Dong-quan/STM32_LoRa_IoT_Output_Controller/README.md

# STM32 LoRa IoT Output Controller



[]()
[]()
[]()

---

## Table of Contents

1. [Overview](#overview)
2. [Design Requirements](#design-requirements)
3. [Hardware Design](#hardware-design)
   - [System Architecture](#system-architecture)
   - [Schematic](#schematic)
   - [PCB Layout and Routing](#pcb-layout-and-routing)
4. [Repository Structure](#repository-structure)
5. [Getting Started](#getting-started)
6. [Author](#author)

---

## Overview

This project is an **IoT output controller board** designed in KiCad. An **STM32F103C8T6** reads isolated digital inputs, drives power outputs and talks to a remote node through a **LoRa** module. It is built to run field equipment such as a pump, two valves, a fan, a light, a buzzer and a curtain motor, so it fits a greenhouse or smart-agriculture system.

Field circuits are separated from the logic side with **optocouplers**, which protects the MCU from noise and faults on the load side. The board can be powered from mains (AC-DC module) and from a 12 / 24 V DC source.

Main functions:

- **Control** the pump, valve 1, valve 2, fan and light with opto-isolated MOSFET outputs.
- **Switch** two relay outputs for larger AC loads.
- **Drive a motor** (for example a curtain) through a **BTS7960** H-bridge interface with PWM and high-speed optocouplers.
- **Read** six isolated inputs: four switches and two limit switches.
- **Communicate** over LoRa (UART, with M0, M1 and AUX control) and over a USART port.
- **Indicate** status with LEDs and a buzzer.

---

## Design Requirements

### Summary

| Item | Target |
| --- | --- |
| MCU | STM32F103C8T6 (8 MHz crystal, 32.768 kHz RTC crystal) |
| Wireless | LoRa module over UART |
| Power input | AC mains (AC-DC module) or 12 / 24 V DC |
| Logic supply | 5 V and 3.3 V, separated from the load supply |
| Inputs | 6 opto-isolated digital inputs |
| Outputs | 5 MOSFET outputs, 2 relays, 1 H-bridge interface |
| Programming | SWD |
| Revision | V1.0 |

### Functional requirements

**Power**
- Fuse, varistor and EMI filter on the AC input
- AC-DC module for 5 V, and a buck converter for 12 / 24 V DC input
- 3.3 V LDO for the MCU, LoRa and input side
- Reverse-polarity protection and a TVS or Zener clamp on the DC input

**Inputs**
- Six opto-isolated inputs (4 switches and 2 limit switches), with resistor values for 12 V and 24 V operation
- Status LED on each channel

**Outputs**
- Five MOSFET outputs with flyback protection, isolated by optocouplers
- Two relay outputs
- BTS7960 H-bridge interface with LPWM and RPWM through high-speed optocouplers

**Microcontroller and communication**
- STM32 MCU with SWD, USART, reset button and boot pin
- LoRa module interface (TX, RX, M0, M1, AUX)
- Buzzer and test LED

---

## Hardware Design

### System Architecture

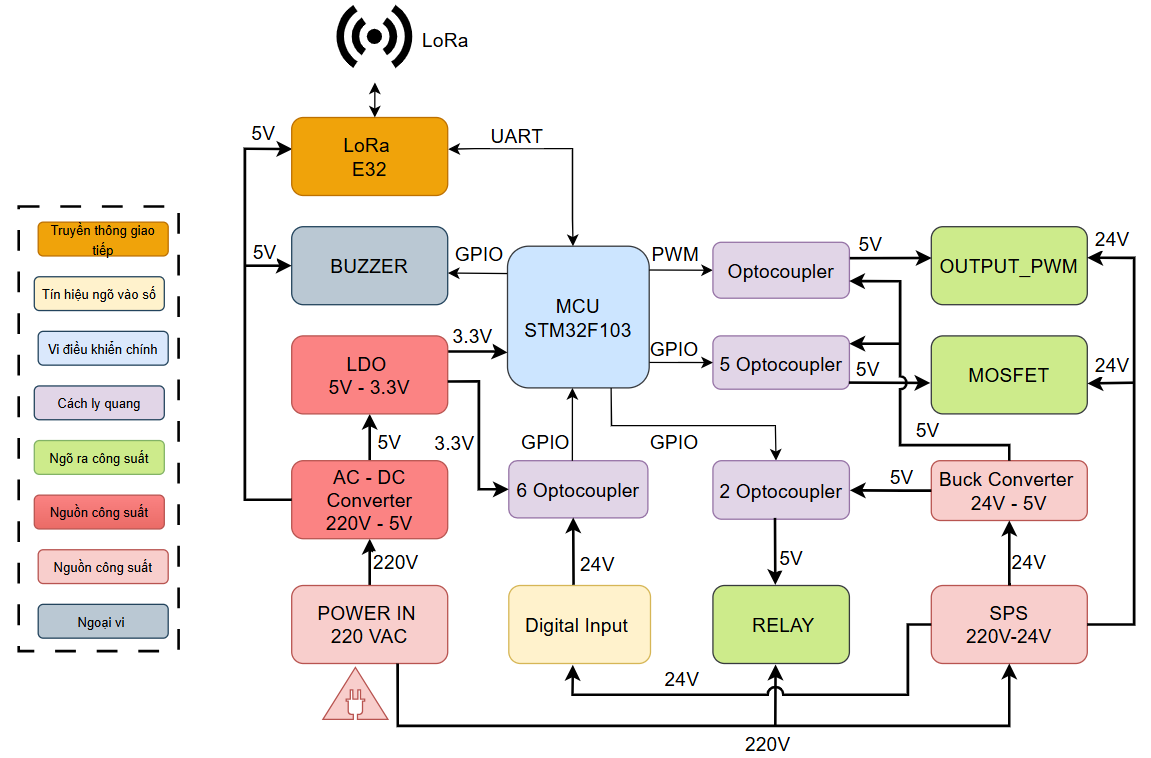
[picture p1: Images/sdk.png]
System block diagram


The design is split into six hierarchical sheets:

| Sheet | File | Function |
| --- | --- | --- |
| POWER | `AC_DC_DC.kicad_sch` | Mains and DC input, protection, 5 V and 3.3 V rails |
| MCU | `MCU.kicad_sch` | STM32F103C8T6, crystals, reset, SWD, USART, buzzer, LEDs |
| LORA | `LoRa.kicad_sch` | LoRa module connector and control lines |
| INPUT | `Input.kicad_sch` | Six opto-isolated inputs (EL357N) |
| POWER STAGE | `Powerstage.kicad_sch` | MOSFET and relay outputs, optocoupler isolation (EL357N) |
| BTS7960 | `BTS7960.kicad_sch` | H-bridge interface with HCPL-2631 optocouplers |

The top-level sheet is `Board_Output.kicad_sch`.

### Schematic

Key parts, taken from the schematic:

| Block | Main components |
| --- | --- |
| MCU | STM32F103C8T6, 8 MHz and 32.768 kHz crystals, SI2300 MOSFET (buzzer drive) |
| Power | HLK-PM01 and HLK-5M05 AC-DC modules, TPS5430 buck, AMS1117 3.3 V, SS54 Schottky, fuse, varistor 10D561, EMI filter |
| Inputs | EL357N optocouplers, EL817 optocoupler, XH2.54 connectors |
| Power stage | AOD4184 MOSFETs, EL357N optocouplers, G5NB relays, SS56 / SS34 / 1N4007 flyback diodes |
| H-bridge | HCPL-2631 high-speed optocouplers, BTS7960 module headers |

**Signal map (MCU nets)**

| Group | Nets |
| --- | --- |
| Outputs | `STM_PUMP`, `STM_FAN`, `STM_VAN1`, `STM_VAN2`, `STM_RELAY1`, `STM_RELAY2`, `STM_BUZZ` |
| Motor PWM | `STM_LPWM`, `STM_RPWM` |
| Inputs | `STM_SW1` – `STM_SW4`, `STM_LSW1`, `STM_LSW2` |
| LoRa | `LoRa_Tx`, `LoRa_Rx`, `LoRa_M0`, `LoRa_M1`, `LoRa_AUX` |
| Debug | `SWDIO`, `SWCLK`, `USART_Tx`, `USART_Rx`, `STM_LEDTEST` |

### PCB Layout and Routing

The PCB keeps the logic and LoRa side apart from the switching and load side. Optocouplers sit on the boundary so that the isolation gap is clear on the board.

**Layout**

| Top layer | Bottom layer |
| :---: | :---: |
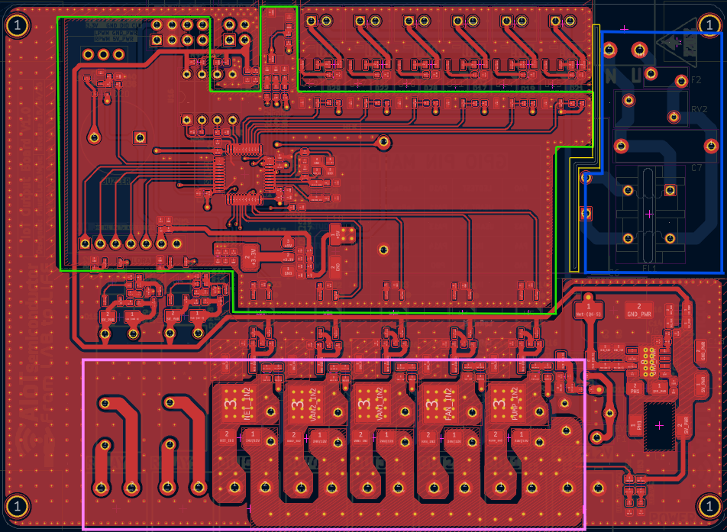
[picture p2: Images/top.png]
PCB top
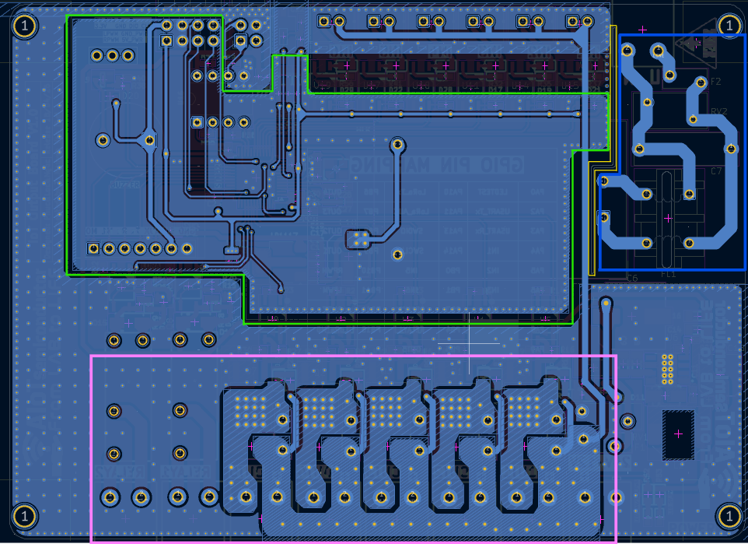
[picture p3: Images/bot.png]
PCB bottom
|  |  |

**3D view**

| Top side | Bottom side |
| :---: | :---: |
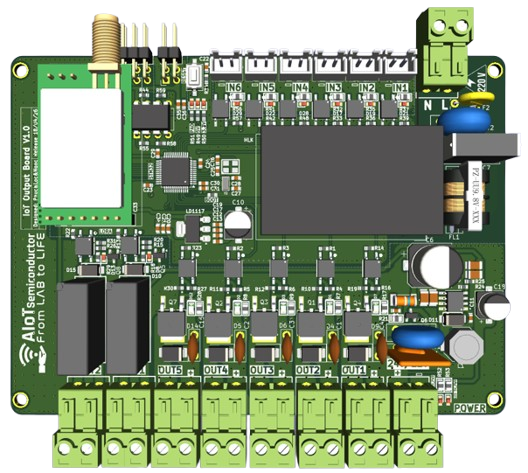
[picture p4: Images/3Dtop.png]
3D top
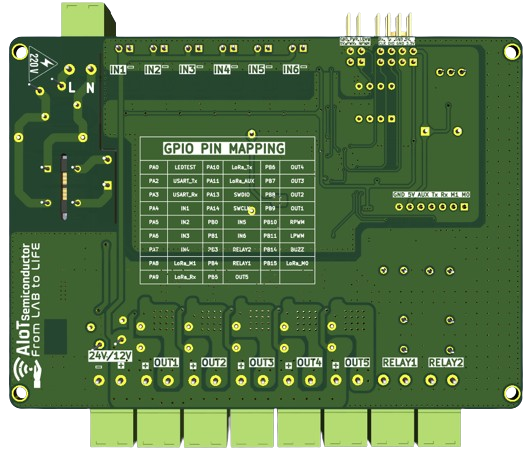
[picture p5: Images/3Dbot.png]
3D bottom
|  |  |

---

## Repository Structure

```
Kicad_BLDC_Motor/
├── Images/                     # Block diagram, PCB and 3D renders
├── bom/                        # Bill of materials
├── Board_Output.kicad_pro      # KiCad project
├── Board_Output.kicad_prl      # Project local settings
├── Board_Output.kicad_sch      # Top-level schematic
├── AC_DC_DC.kicad_sch          # Power input and rails
├── MCU.kicad_sch               # STM32F103C8T6
├── LoRa.kicad_sch              # LoRa interface
├── Input.kicad_sch             # Opto-isolated inputs
├── Powerstage.kicad_sch        # MOSFET and relay outputs
├── BTS7960.kicad_sch           # H-bridge interface
├── OutputPCB/                  # PCB layout files
├── .gitignore
└── README.md
```

---

## Getting Started

1. Install [KiCad](https://www.kicad.org/download/) 9.0 or newer.
2. Clone the repository:

   ```bash
   git clone https://github.com/Dong-quan/Kicad_BLDC_Motor.git
   cd Kicad_BLDC_Motor
   ```

3. Open `Board_Output.kicad_pro` to view or edit the schematic and PCB.
4. Use the files in `bom/` for component ordering.

**Safety note.** The AC input and relay contacts carry mains voltage. Check creepage and clearance, and test with a current-limited source before connecting loads.

---

## Author

- **Huynh Vo Phuc Loc**
- GitHub: [Dong-quan](https://github.com/Dong-quan)
