Dong-quan/STM32_LoRa_IoT_Output_Controller/AC_DC_DC.kicad_sch

## KiCad design AC_DC_DC.kicad_sch (2026-10-30)

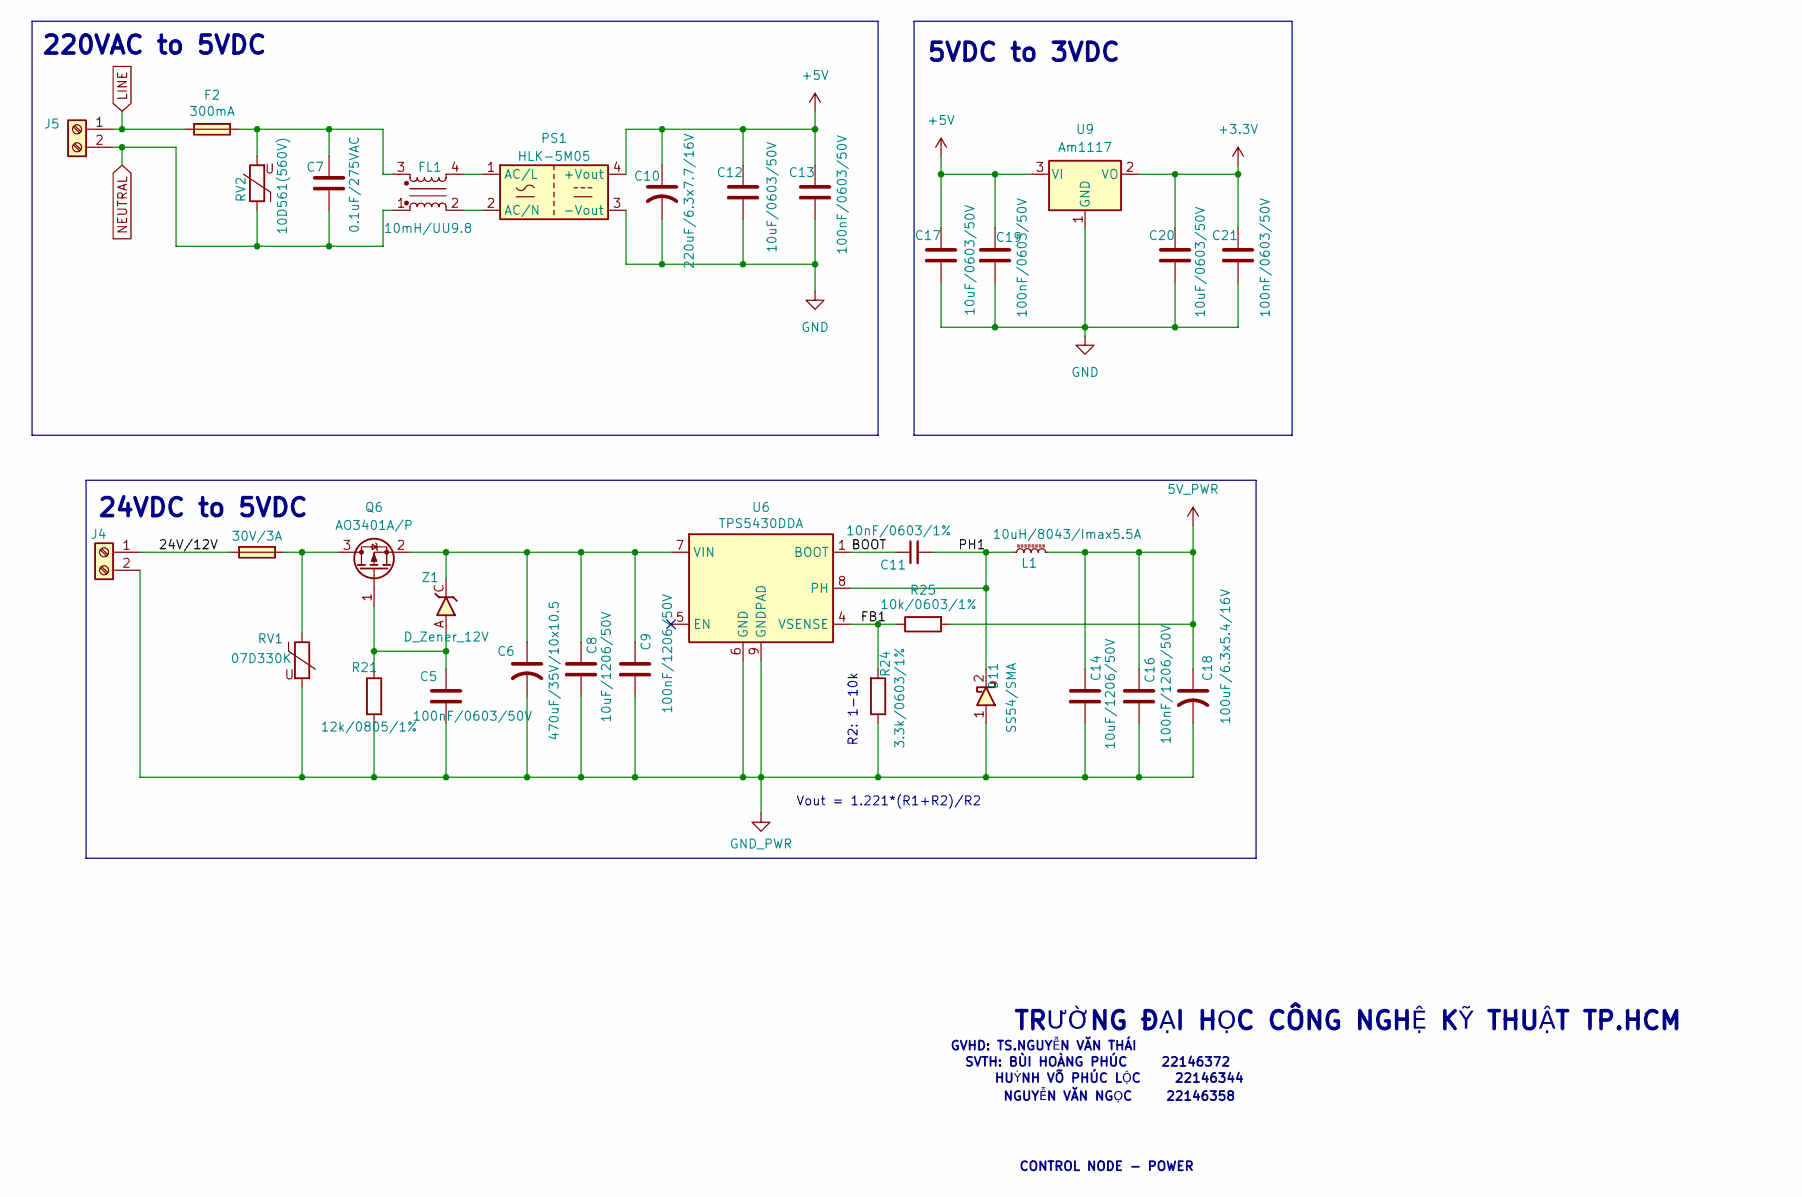
[picture p6: schematic AC_DC_DC.kicad_sch]

Parts:
C5, C13, C19, C21: 100nF/0603/50V; C_0603
C6: 470uF/35V/10x10.5; CP_Elec_10x10.5
C7: 0.1uF/275VAC; C_Rect_L16.5mm_W5.0mm_P15.00mm_MKT
C8, C14: 10uF/1206/50V; C_1206
C9, C16: 100nF/1206/50V; C_1206
C10: 220uF/6.3x7.7/16V; CP_Elec_6.3x7.7
C11: 10nF/0603/1%; C_0603; LCSC C1589
C12, C17, C20: 10uF/0603/50V; C_0603
C18: 100uF/6.3x5.4/16V; CP_Elec_6.3x5.4
D11: SS54/SMA; D_SMA; LCSC C22452
F1: 30V/3A; Fuse_Bourns_MF-RG500
F2: 300mA; Fuse_Bourns_MF-RG300
FL1: 10mH/UU9.8; ACFilterChoke-UU9.8
J4, J5: Screw_Terminal_01x02; KF-5.08-2P
L1: 10uH/8043/Imax5.5A; L_8043; LCSC C2929499
PS1: HLK-5M05; Converter_ACDC_Hi-Link_HLK-5Mxx
Q6: AO3401A/P; SOT23-3
R21: 12k/0805/1%; R_0805
R24: 3.3k/0603/1%; R_0603
R25: 10k/0603/1%; R_0603
RV1: 07D330K; RV_Disc_D12mm_W4.2mm_P7.5mm
RV2: 10D561(560V); RV_Disc_D12mm_W5.8mm_P7.5mm
U6: TPS5430DDA; TPS5430DDAR; LCSC C9864
U9: Am1117; SOT-223-3_TabPin2
Z1: D_Zener_12V; DO_123AB

Connections:
5V_PWR: C14.1, C16.1, C18.1, L1.2, R25.2
24V/12V: F1.1, J4.1
+3.3V: C20.1, C21.1, U9.2 (VO)
+5V: C10.1, C12.1, C13.1, C17.1, C19.1, PS1.4 (+Vout), U9.3 (VI)
BOOT: C11.1, U6.1 (BOOT)
FB1: R24.2, R25.1, U6.4 (VSENSE)
GND: C10.2, C12.2, C13.2, C17.2, C19.2, C20.2, C21.2, PS1.3 (-Vout), U9.1 (GND)
GND_PWR: C5.2, C6.2, C8.2, C9.2, C14.2, C16.2, C18.2, D11.1, J4.2, R21.2, R24.1, RV1.2, U6.6 (GND), U6.9 (GNDPAD)
LINE: F2.1, J5.1
NEUTRAL: C7.2, FL1.1, J5.2, RV2.1
unnamed: C5.1, Q6.1 (G), R21.1, Z1.A
unnamed: C6.1, C8.1, C9.1, Q6.2 (S), U6.7 (VIN), Z1.C
unnamed: C7.1, F2.2, FL1.3, RV2.2
unnamed: F1.2, Q6.3 (D), RV1.1
unnamed: FL1.2, PS1.2 (AC/N)
unnamed: FL1.4, PS1.1 (AC/L)
PH1: C11.2, D11.2, L1.1, U6.8 (PH)

Notes on the sheet:
NGUYỄN VĂN NGỌC 22146358
24VDC to 5VDC
CONTROL NODE - POWER
SVTH: BÙI HOÀNG PHÚC 22146372
R2: 1-10k
220VAC to 5VDC
Vout = 1.221*(R1+R2)/R2
5VDC to 3VDC
TRƯỜNG ĐẠI HỌC CÔNG NGHỆ KỸ THUẬT TP.HCM
HUỲNH VÕ PHÚC LỘC 22146344
GVHD: TS.NGUYỄN VĂN THÁI
