Dong-quan/STM32_LoRa_IoT_Output_Controller/BTS7960.kicad_sch

## KiCad design BTS7960.kicad_sch (2026-10-30)

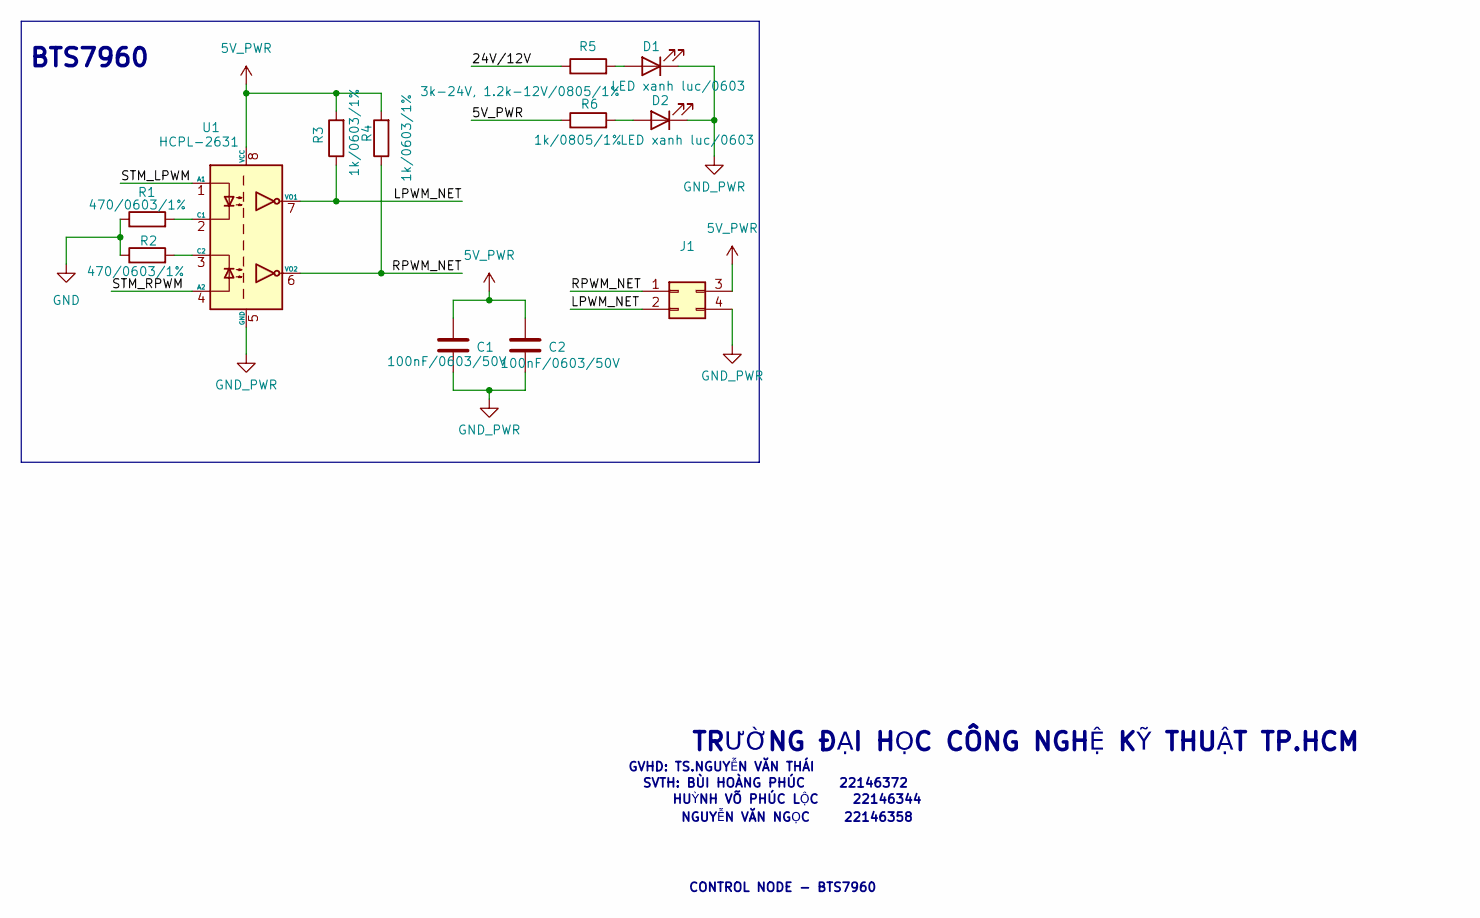
[picture p7: schematic BTS7960.kicad_sch]

Parts:
C1, C2: 100nF/0603/50V; C_0603
D1, D2: LED xanh luc/0603; LED_0603
J1: Conn_02x02_Top_Bottom; PinHeader_2x02_P2.54mm_Horizontal
R1, R2: 470/0603/1%; R_0603
R3, R4: 1k/0603/1%; R_0603; LCSC C14676
R5: 3k-24V, 1.2k-12V/0805/1%; R_0805; LCSC C14676
R6: 1k/0805/1%; R_0805
U1: HCPL-2631; DIP-8_W7.62mm

Connections:
5V_PWR: C1.2, C2.2, J1.3, R3.2, R4.2, R6.1, U1.8 (VCC)
24V/12V: R5.1
GND: R1.1, R2.1
GND_PWR: C1.1, C2.1, D1.1 (K), D2.1 (K), J1.4, U1.5 (GND)
LPWM_NET: J1.2, R3.1, U1.7 (VO1)
unnamed: D1.2 (A), R5.2
unnamed: D2.2 (A), R6.2
unnamed: R1.2, U1.2 (C1)
unnamed: R2.2, U1.3 (C2)
RPWM_NET: J1.1, R4.1, U1.6 (VO2)
STM_LPWM: U1.1 (A1)
STM_RPWM: U1.4 (A2)

Notes on the sheet:
NGUYỄN VĂN NGỌC 22146358
BTS7960
CONTROL NODE - BTS7960
TRƯỜNG ĐẠI HỌC CÔNG NGHỆ KỸ THUẬT TP.HCM
GVHD: TS.NGUYỄN VĂN THÁI
HUỲNH VÕ PHÚC LỘC 22146344
SVTH: BÙI HOÀNG PHÚC 22146372
