Dong-quan/STM32_LoRa_IoT_Output_Controller/Board_Output.kicad_sch

## KiCad design Board_Output.kicad_sch (2026-10-30)

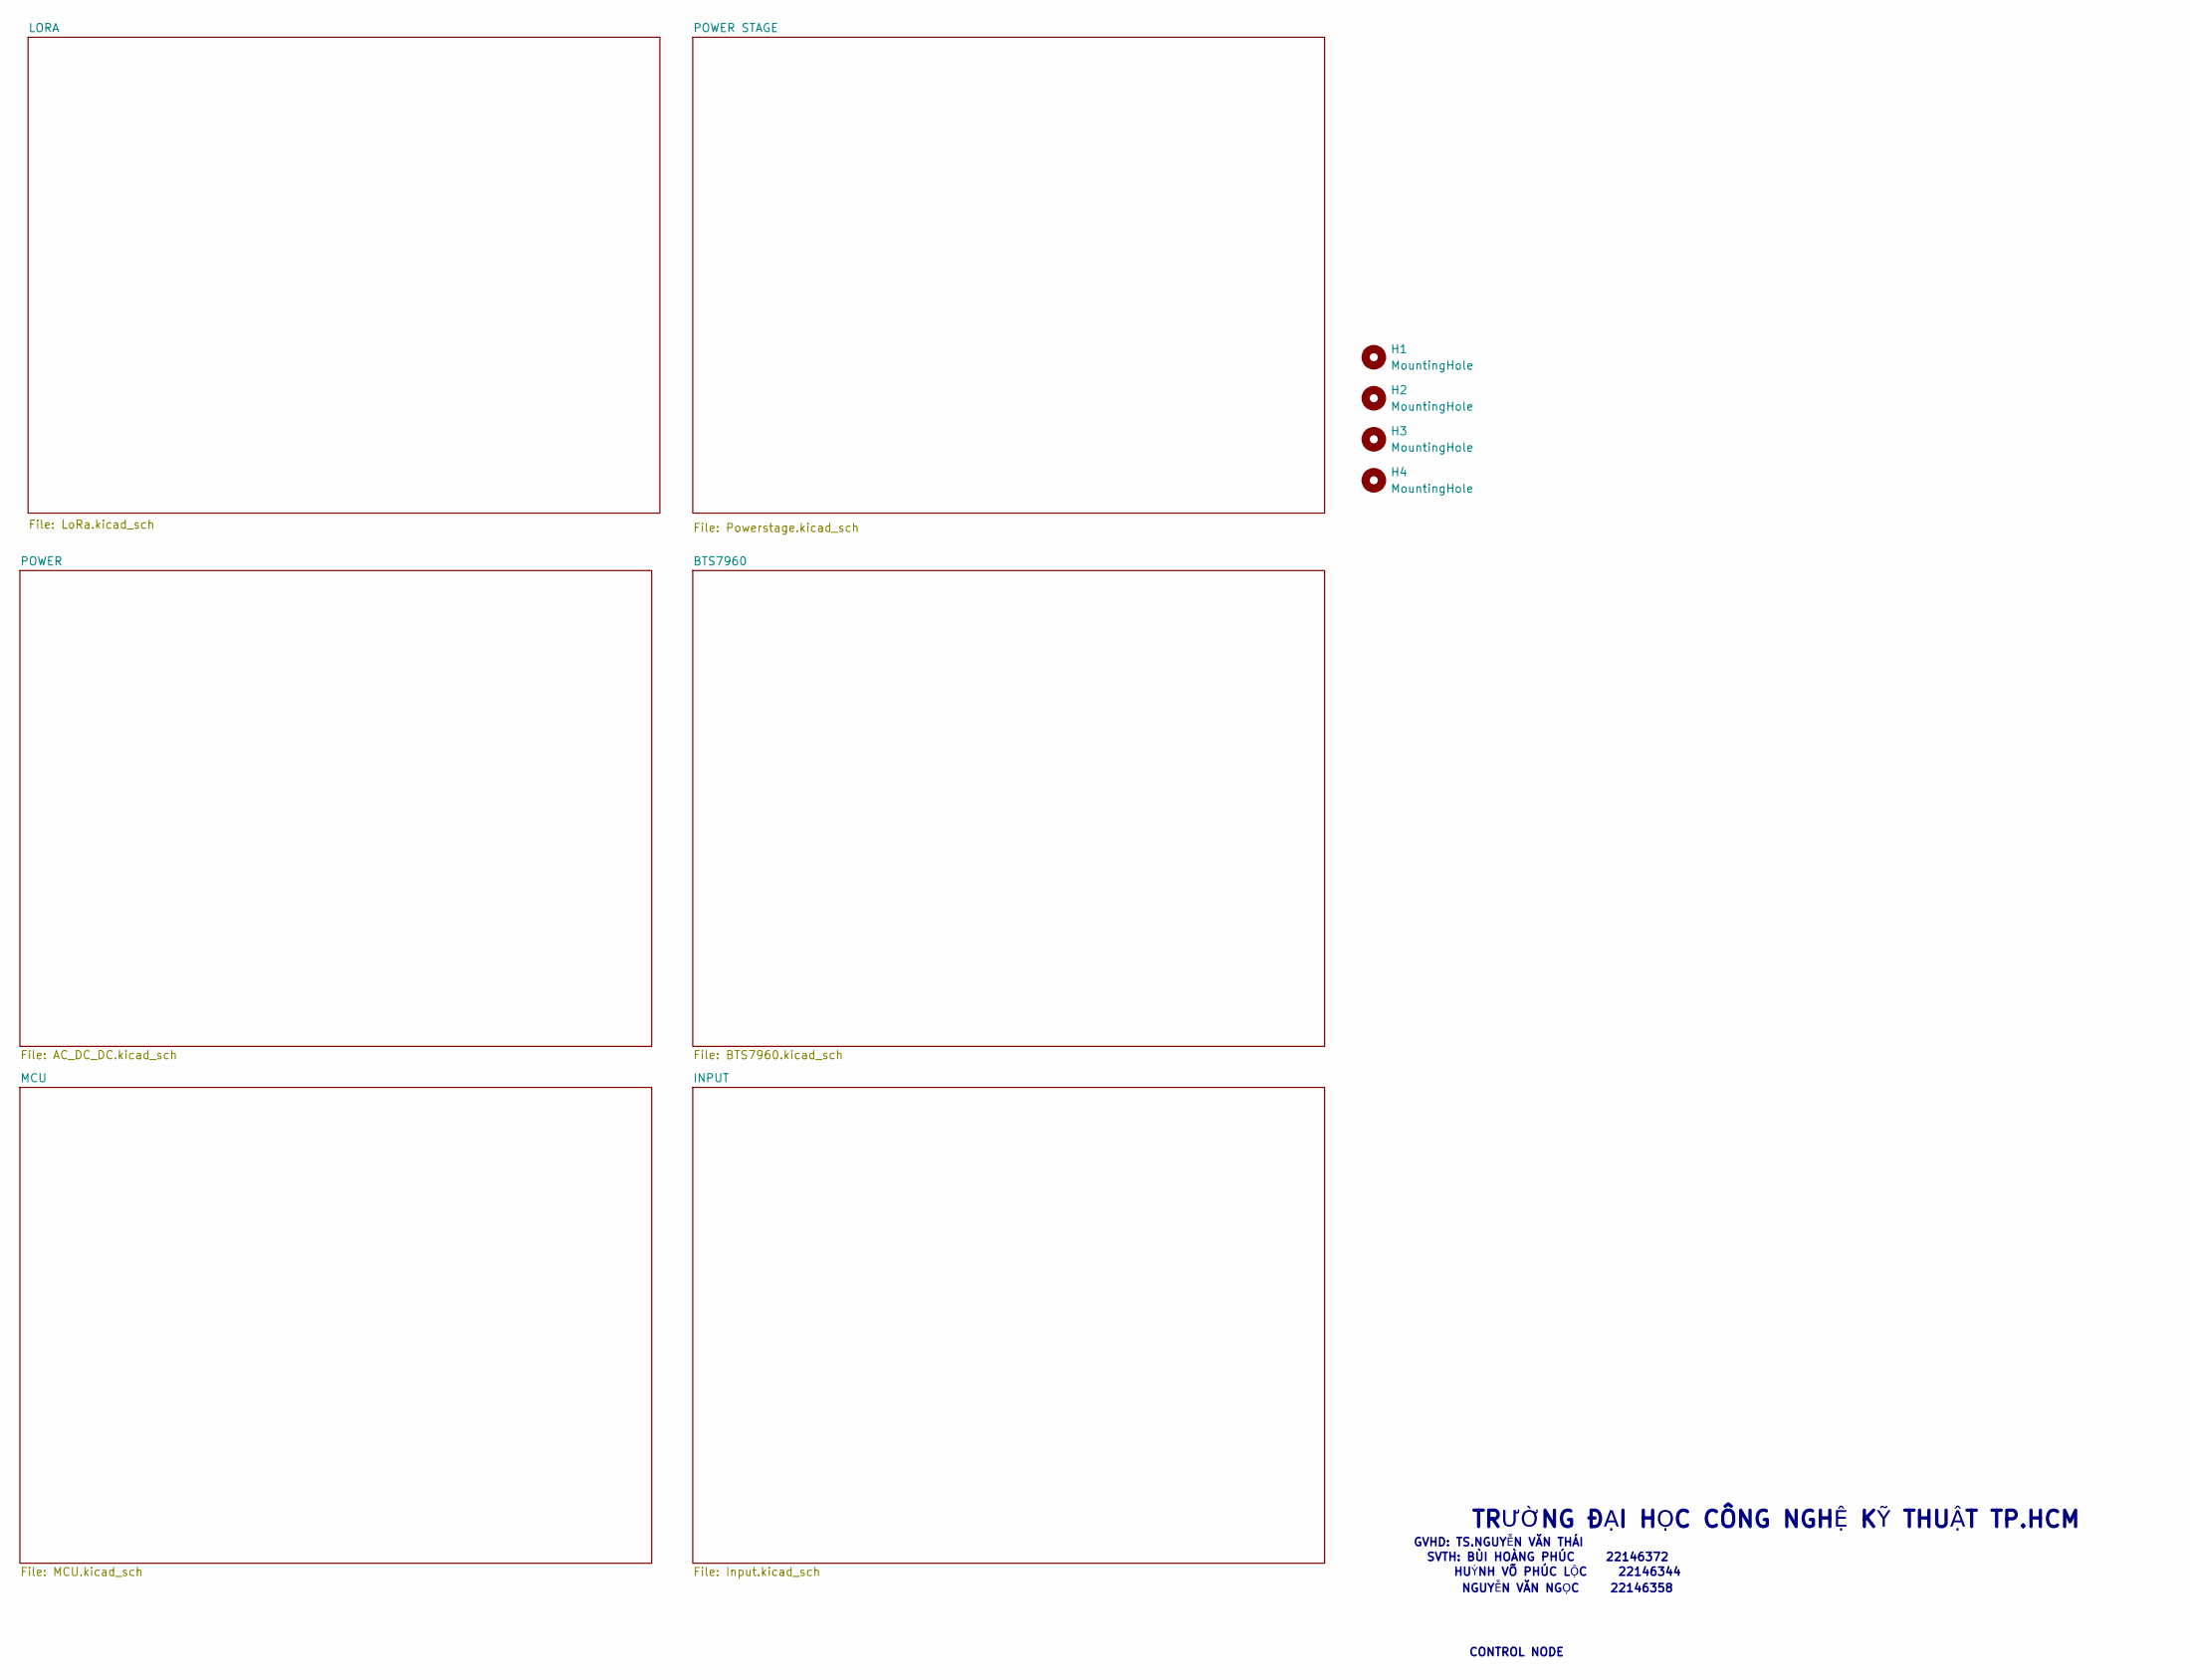
[picture p8: schematic Board_Output.kicad_sch]

Parts:
H1, H2, H3, H4: MountingHole; MountingHole_3.2mm_M3_Pad_Via

Notes on the sheet:
NGUYỄN VĂN NGỌC 22146358
GVHD: TS.NGUYỄN VĂN THÁI
CONTROL NODE
TRƯỜNG ĐẠI HỌC CÔNG NGHỆ KỸ THUẬT TP.HCM
HUỲNH VÕ PHÚC LỘC 22146344
SVTH: BÙI HOÀNG PHÚC 22146372
