Dong-quan/STM32_LoRa_IoT_Output_Controller/Input.kicad_sch

## KiCad design Input.kicad_sch (2026-10-30)

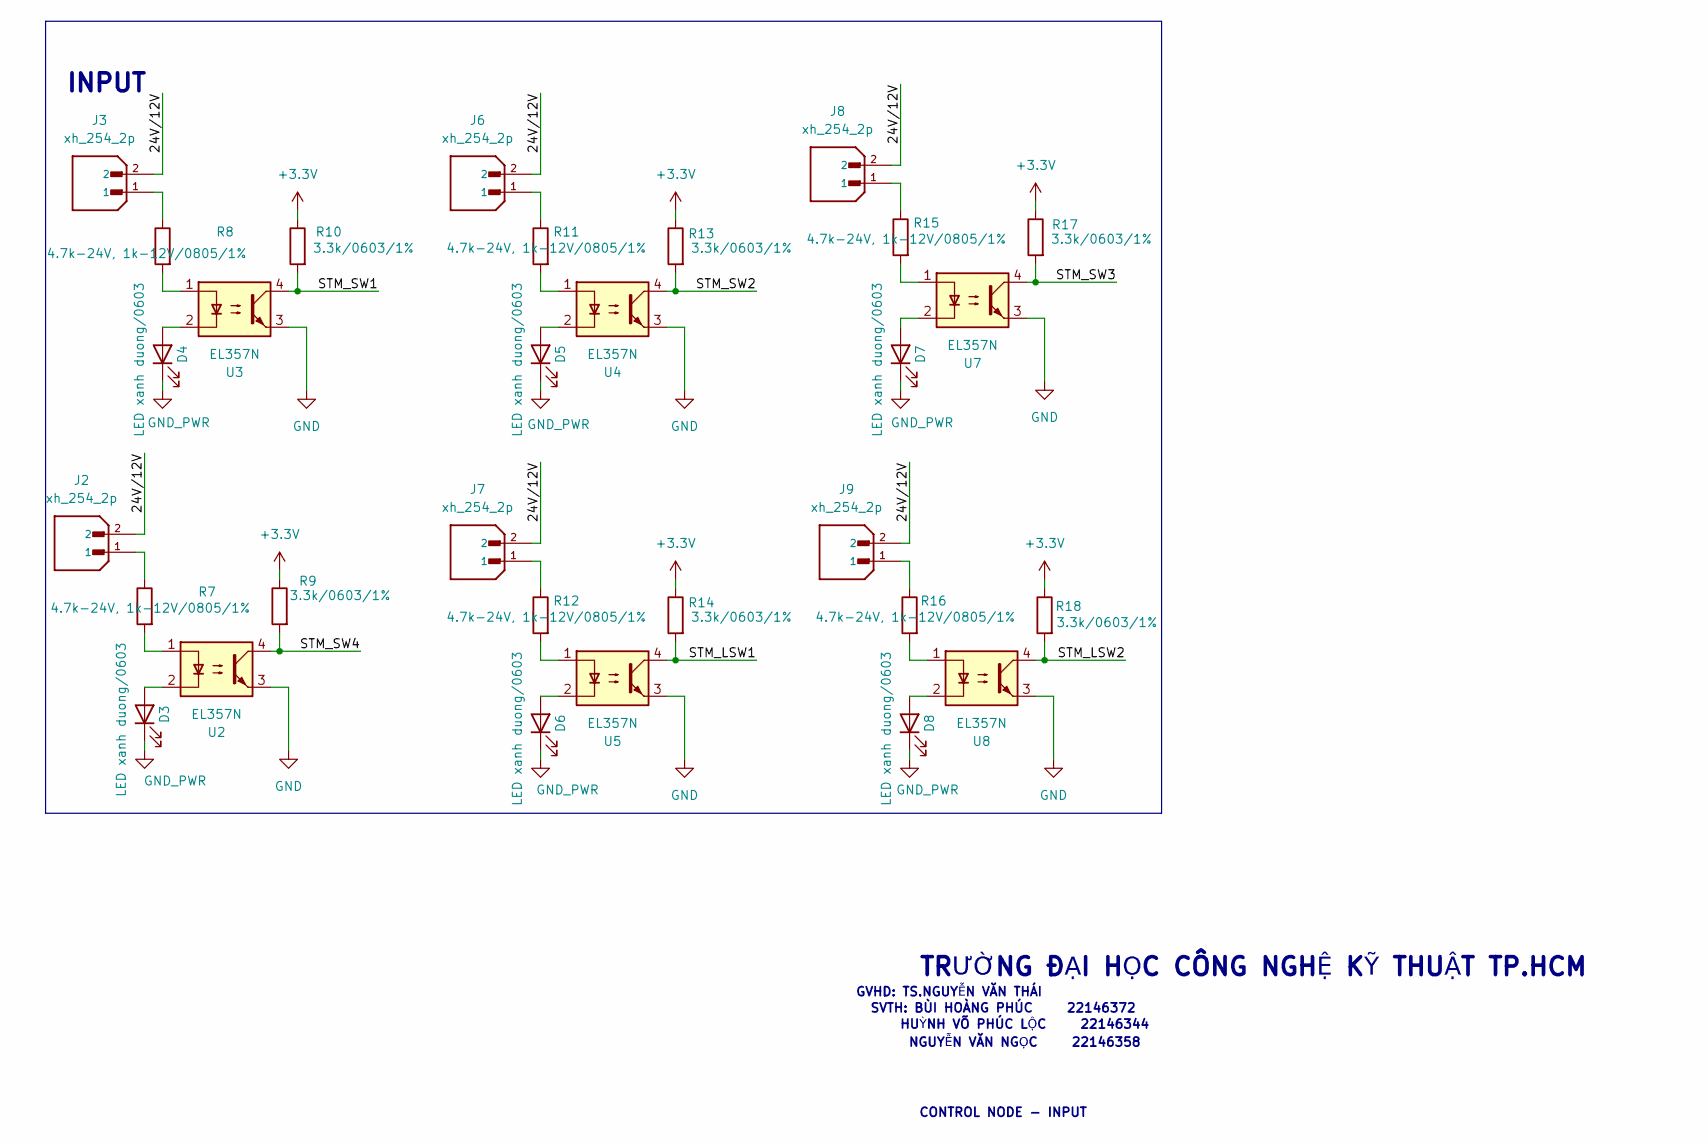
[picture p9: schematic Input.kicad_sch]

Parts:
D3, D4, D5, D6, D7, D8: LED xanh duong/0603; LED_0603
J2, J3, J6, J7, J8, J9: xh_254_2p; PARTREV N/A
R7, R8, R11, R12, R15, R16: 4.7k-24V, 1k-12V/0805/1%; R_0805
R9, R10, R13, R14, R17, R18: 3.3k/0603/1%; R_0603
U2, U3, U4, U5, U7, U8: EL357N; OptoIsolation-EL357N-G

Connections:
24V/12V: J2.2, J3.2, J6.2, J7.2, J8.2, J9.2
+3.3V: R9.1, R10.1, R13.1, R14.1, R17.1, R18.1
GND: U2.3, U3.3, U4.3, U5.3, U7.3, U8.3
GND_PWR: D3.1 (K), D4.1 (K), D5.1 (K), D6.1 (K), D7.1 (K), D8.1 (K)
unnamed: D3.2 (A), U2.2
unnamed: D4.2 (A), U3.2
unnamed: D5.2 (A), U4.2
unnamed: D6.2 (A), U5.2
unnamed: D7.2 (A), U7.2
unnamed: D8.2 (A), U8.2
unnamed: J2.1, R7.1
unnamed: J3.1, R8.1
unnamed: J6.1, R11.1
unnamed: J7.1, R12.1
unnamed: J8.1, R15.1
unnamed: J9.1, R16.1
unnamed: R7.2, U2.1
unnamed: R8.2, U3.1
unnamed: R11.2, U4.1
unnamed: R12.2, U5.1
unnamed: R15.2, U7.1
unnamed: R16.2, U8.1
STM_LSW1: R14.2, U5.4
STM_LSW2: R18.2, U8.4
STM_SW1: R10.2, U3.4
STM_SW2: R13.2, U4.4
STM_SW3: R17.2, U7.4
STM_SW4: R9.2, U2.4

Notes on the sheet:
SVTH: BÙI HOÀNG PHÚC 22146372
NGUYỄN VĂN NGỌC 22146358
TRƯỜNG ĐẠI HỌC CÔNG NGHỆ KỸ THUẬT TP.HCM
HUỲNH VÕ PHÚC LỘC 22146344
GVHD: TS.NGUYỄN VĂN THÁI
CONTROL NODE - INPUT
INPUT
