Dong-quan/STM32_LoRa_IoT_Output_Controller/LoRa.kicad_sch

## KiCad design LoRa.kicad_sch (2026-10-30)

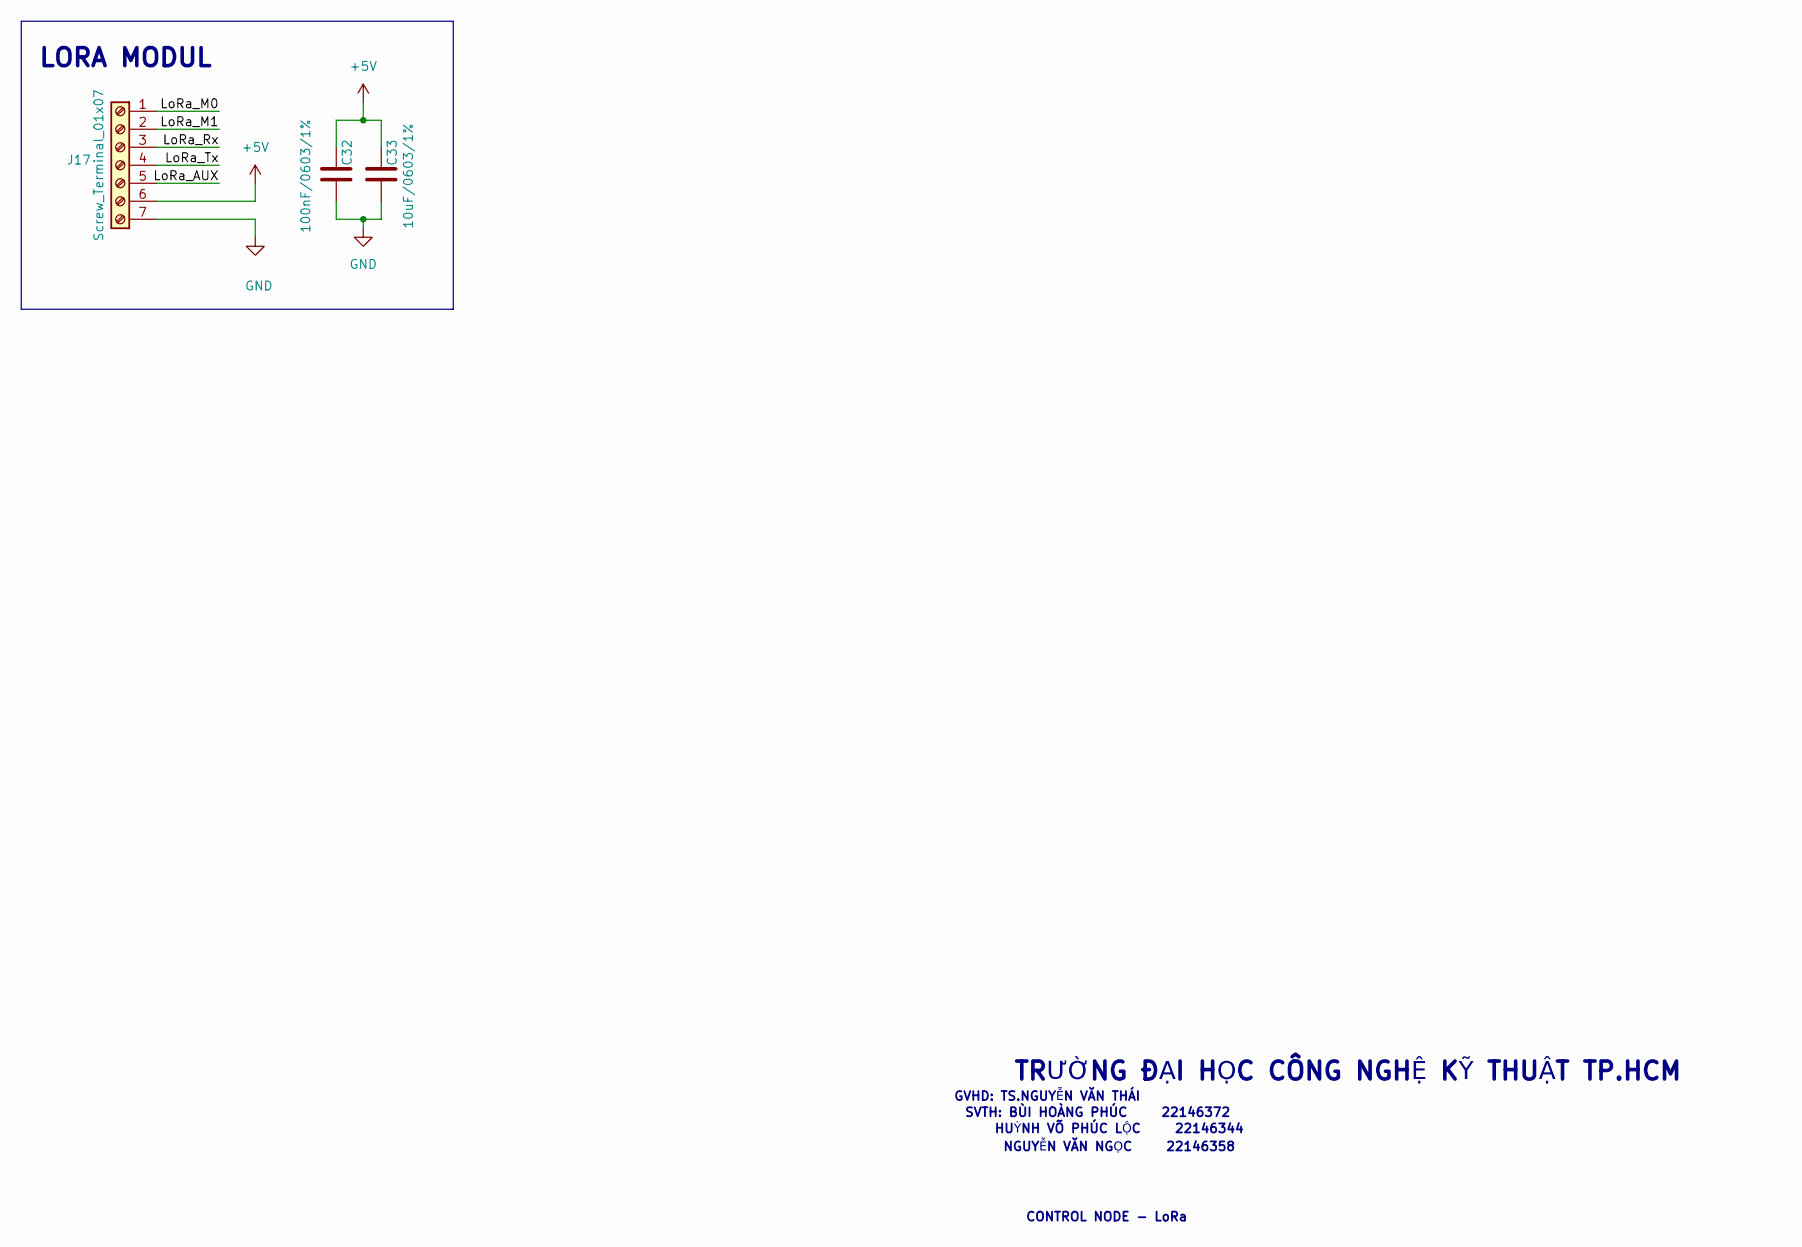
[picture p10: schematic LoRa.kicad_sch]

Parts:
C32: 100nF/0603/1%; C_0603
C33: 10uF/0603/1%; C_0603
J17: Screw_Terminal_01x07; E32

Connections:
+5V: C32.1, C33.1, J17.6
GND: C32.2, C33.2, J17.7
LoRa_AUX: J17.5
LoRa_M0: J17.1
LoRa_M1: J17.2
LoRa_Rx: J17.3
LoRa_Tx: J17.4

Notes on the sheet:
TRƯỜNG ĐẠI HỌC CÔNG NGHỆ KỸ THUẬT TP.HCM
SVTH: BÙI HOÀNG PHÚC 22146372
NGUYỄN VĂN NGỌC 22146358
HUỲNH VÕ PHÚC LỘC 22146344
LORA MODUL
GVHD: TS.NGUYỄN VĂN THÁI
CONTROL NODE - LoRa
