Dong-quan/STM32_LoRa_IoT_Output_Controller/MCU.kicad_sch

## KiCad design MCU.kicad_sch (2026-10-30)

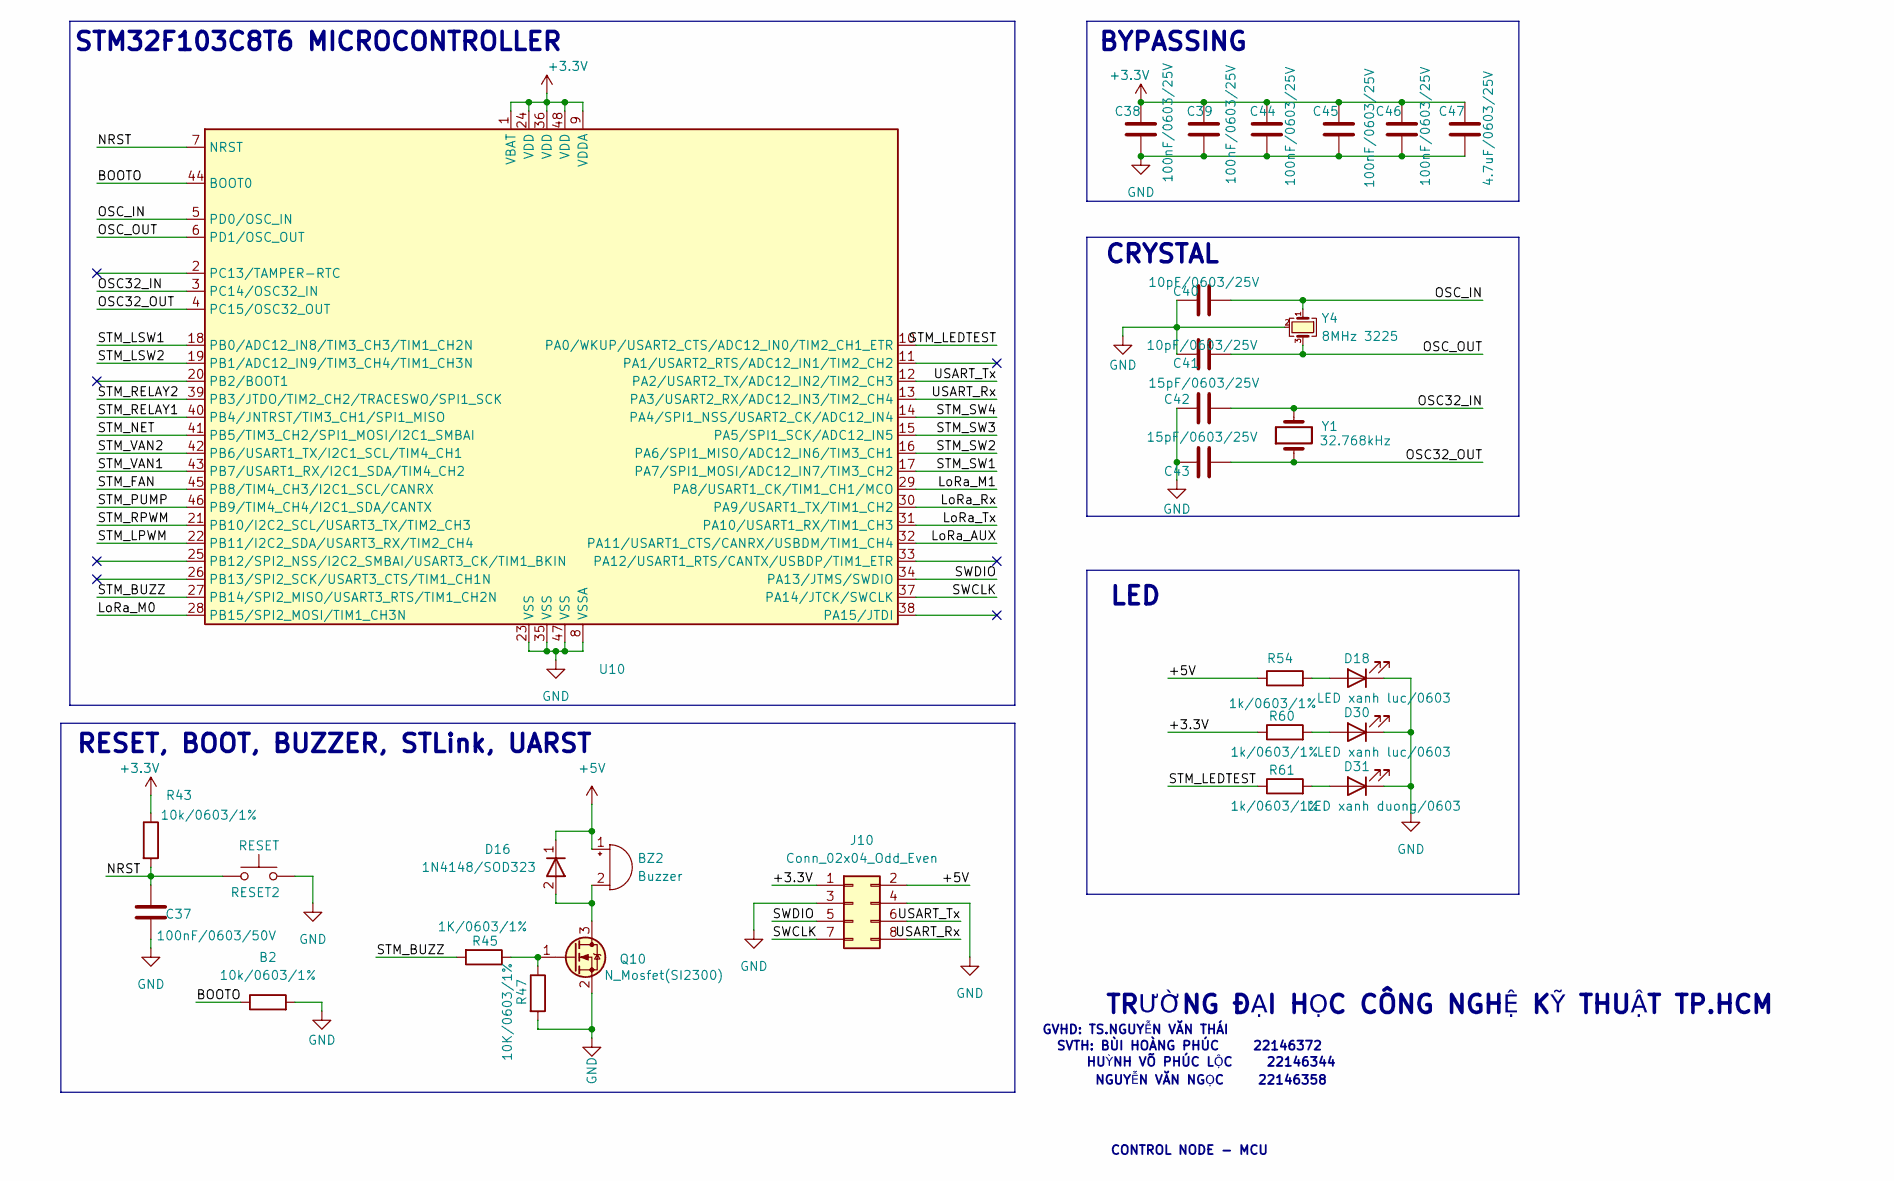
[picture p11: schematic MCU.kicad_sch]

Parts:
B2: 10k/0603/1%; R_0603
BZ2: Buzzer; Buzzer-THT-12x9.5_RM7.6
C37: 100nF/0603/50V; C_0603
C38, C39, C44, C45, C46: 100nF/0603/25V; C_0603
C40, C41: 10pF/0603/25V; C_0603
C42, C43: 15pF/0603/25V; C_0603
C47: 4.7uF/0603/25V; C_0603
D16: 1N4148/SOD323; D_SOD-323
D18, D30: LED xanh luc/0603; LED_0603
D31: LED xanh duong/0603; LED_0603
J10: Conn_02x04_Odd_Even; PinHeader_2x04_P2.54mm_Horizontal
Q10: N_Mosfet(SI2300); SOT23-3
R43: 10k/0603/1%; R_0603
R45: 1K/0603/1%; R_0603
R47: 10K/0603/1%; R_0603
R54: 1k/0603/1%; R_0603; LCSC C14676
R60, R61: 1k/0603/1%; R_0603
RESET2: RESET; SW_Tactile_SPST_NO_Straight_CK_PTS636Sx25SMTRLFS
U10: MCU_STM32F103C8Tx; LQFP-48_7x7mm_P0.5mm
Y1: 32.768kHz; Crystal_SMD_3215-2Pin_3.2x1.5mm
Y4: 8MHz 3225; Crystal-SMD-4P-3.2x2.6mm-3225

Connections:
+3.3V: C38.1, C39.1, C44.1, C45.1, C46.1, C47.1, J10.1, R43.1, R60.1, U10.1 (VBAT), U10.9 (VDDA), U10.24 (VDD), U10.36 (VDD), U10.48 (VDD)
+5V: BZ2.1 (-), D16.1 (K), J10.2, R54.1
BOOTO: B2.1, U10.44 (BOOT0)
GND: B2.2, C37.1, C38.2, C39.2, C40.1, C41.1, C42.1, C43.1, C44.2, C45.2, C46.2, C47.2, D18.1 (K), D30.1 (K), D31.1 (K), J10.3, J10.4, Q10.2, R47.2, RESET2.2, U10.8 (VSSA), U10.23 (VSS), U10.35 (VSS), U10.47 (VSS), Y4.2, Y4.4
LoRa_AUX: U10.32 (PA11/USART1_CTS/CANRX/USBDM/TIM1_CH4)
LoRa_M0: U10.28 (PB15/SPI2_MOSI/TIM1_CH3N)
LoRa_M1: U10.29 (PA8/USART1_CK/TIM1_CH1/MCO)
LoRa_Rx: U10.30 (PA9/USART1_TX/TIM1_CH2)
LoRa_Tx: U10.31 (PA10/USART1_RX/TIM1_CH3)
NRST: C37.2, R43.2, RESET2.1, U10.7 (NRST)
unnamed: BZ2.2 (+), D16.2 (A), Q10.3
unnamed: D18.2 (A), R54.2
unnamed: D30.2 (A), R60.2
unnamed: D31.2 (A), R61.2
unnamed: Q10.1, R45.1, R47.1
OSC32_IN: C42.2, U10.3 (PC14/OSC32_IN), Y1.2
OSC32_OUT: C43.2, U10.4 (PC15/OSC32_OUT), Y1.1
OSC_IN: C40.2, U10.5 (PD0/OSC_IN), Y4.1
OSC_OUT: C41.2, U10.6 (PD1/OSC_OUT), Y4.3
STM_BUZZ: R45.2, U10.27 (PB14/SPI2_MISO/USART3_RTS/TIM1_CH2N)
STM_FAN: U10.45 (PB8/TIM4_CH3/I2C1_SCL/CANRX)
STM_LEDTEST: R61.1, U10.10 (PA0/WKUP/USART2_CTS/ADC12_IN0/TIM2_CH1_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)
STM_LPWM: U10.22 (PB11/I2C2_SDA/USART3_RX/TIM2_CH4)
STM_LSW1: U10.18 (PB0/ADC12_IN8/TIM3_CH3/TIM1_CH2N)
STM_LSW2: U10.19 (PB1/ADC12_IN9/TIM3_CH4/TIM1_CH3N)
STM_NET: U10.41 (PB5/TIM3_CH2/SPI1_MOSI/I2C1_SMBAI)
STM_PUMP: U10.46 (PB9/TIM4_CH4/I2C1_SDA/CANTX)
STM_RELAY1: U10.40 (PB4/JNTRST/TIM3_CH1/SPI1_MISO)
STM_RELAY2: U10.39 (PB3/JTDO/TIM2_CH2/TRACESWO/SPI1_SCK)
STM_RPWM: U10.21 (PB10/I2C2_SCL/USART3_TX/TIM2_CH3)
STM_SW1: U10.17 (PA7/SPI1_MOSI/ADC12_IN7/TIM3_CH2)
STM_SW2: U10.16 (PA6/SPI1_MISO/ADC12_IN6/TIM3_CH1)
STM_SW3: U10.15 (PA5/SPI1_SCK/ADC12_IN5)
STM_SW4: U10.14 (PA4/SPI1_NSS/USART2_CK/ADC12_IN4)
STM_VAN1: U10.43 (PB7/USART1_RX/I2C1_SDA/TIM4_CH2)
STM_VAN2: U10.42 (PB6/USART1_TX/I2C1_SCL/TIM4_CH1)
SWCLK: J10.7, U10.37 (PA14/JTCK/SWCLK)
SWDIO: J10.5, U10.34 (PA13/JTMS/SWDIO)
USART_Rx: J10.8, U10.13 (PA3/USART2_RX/ADC12_IN3/TIM2_CH4)
USART_Tx: J10.6, U10.12 (PA2/USART2_TX/ADC12_IN2/TIM2_CH3)

Notes on the sheet:
GVHD: TS.NGUYỄN VĂN THÁI
STM32F103C8T6 MICROCONTROLLER
TRƯỜNG ĐẠI HỌC CÔNG NGHỆ KỸ THUẬT TP.HCM
BYPASSING
HUỲNH VÕ PHÚC LỘC 22146344
LED
SVTH: BÙI HOÀNG PHÚC 22146372
CRYSTAL
NGUYỄN VĂN NGỌC 22146358
CONTROL NODE - MCU
RESET, BOOT, BUZZER, STLink, UARST
