Dong-quan/STM32_LoRa_IoT_Output_Controller/Powerstage.kicad_sch

## KiCad design Powerstage.kicad_sch (2026-10-30)

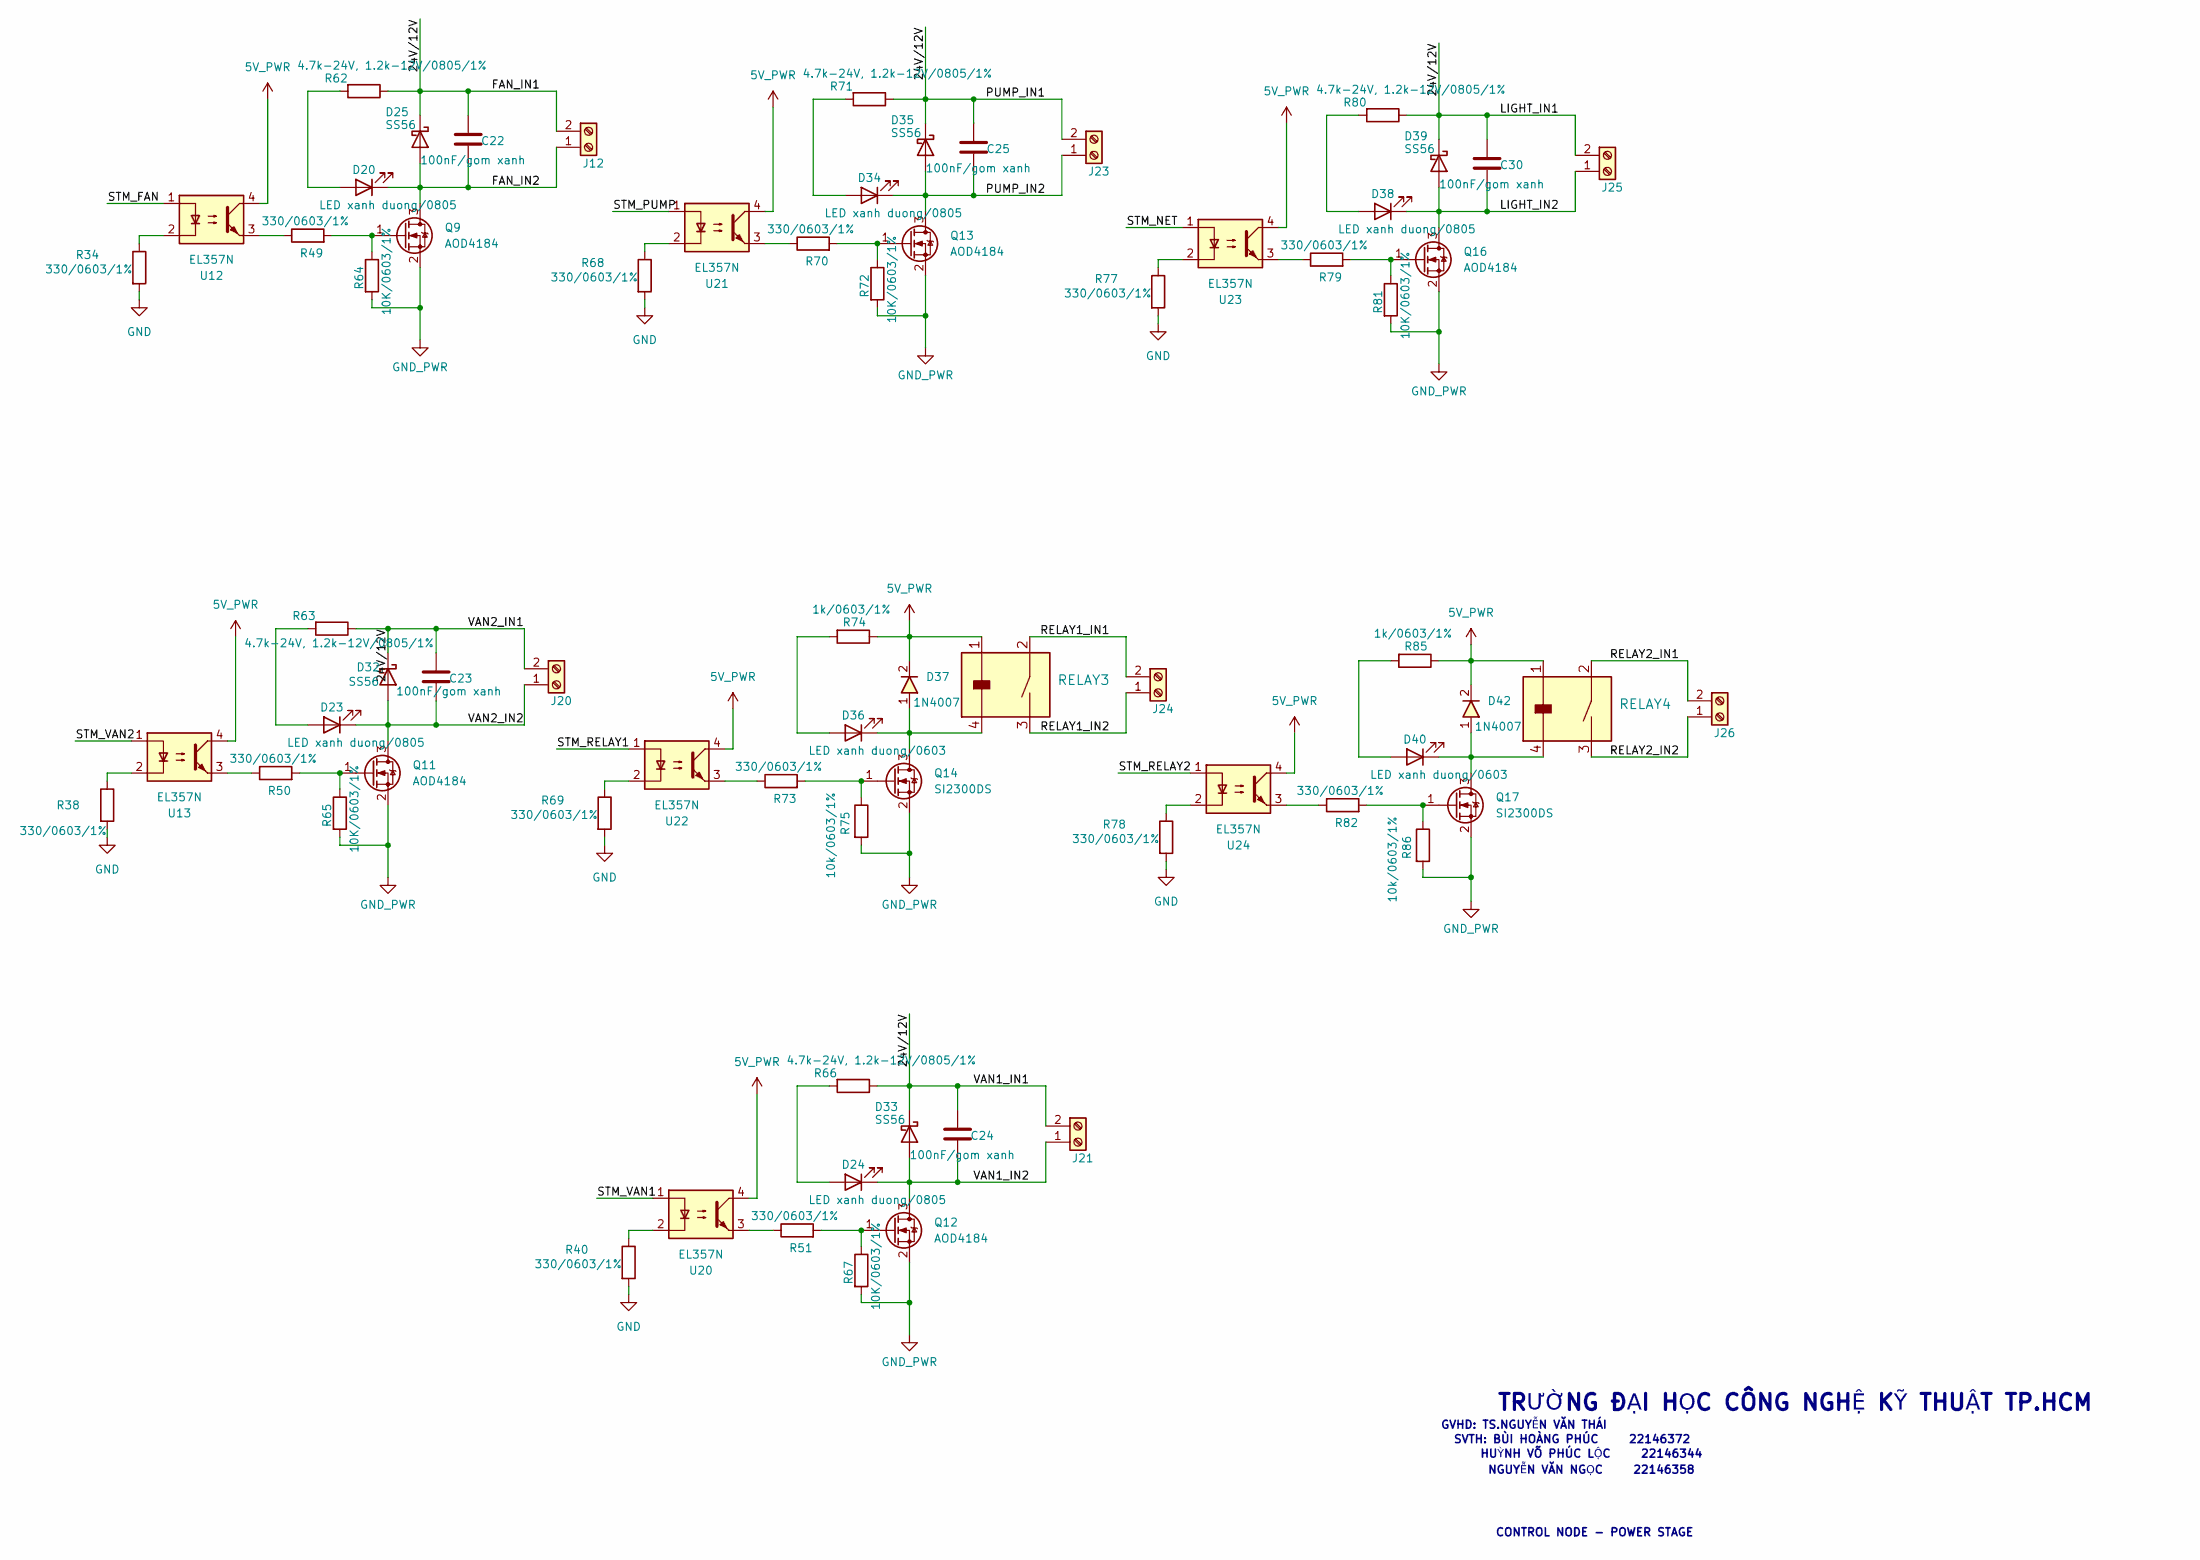
[picture p12: schematic Powerstage.kicad_sch]

Parts:
C22, C23, C24, C25, C30: 100nF/gom xanh; C_Disc_D7.5mm_W2.5mm_P5.00mm
D20, D23, D24, D34, D38: LED xanh duong/0805; LED_0805
D25, D32, D33, D35, D39: SS56; D_SMB
D36, D40: LED xanh duong/0603; LED_0603
D37, D42: 1N4007; D_SMA
J12, J20, J21, J23, J24, J25, J26: Screw_Terminal_01x02; KF-5.08-2P
Q9, Q11, Q12, Q13, Q16: AOD4184; TO252N
Q14, Q17: SI2300DS; SOT-23
R34, R38, R40, R49, R50, R51, R68, R69, R70, R73, R77, R78, R79, R82: 330/0603/1%; R_0603
R62, R63, R66, R71, R80: 4.7k-24V, 1.2k-12V/0805/1%; R_0805
R64, R65, R67, R72, R81: 10K/0603/1%; R_0603
R74, R85: 1k/0603/1%; R_0603
R75, R86: 10k/0603/1%; R_0603
RELAY3, RELAY4: HF46F-G; Relay-G5NB_1A_E_DC5
U12, U13, U20, U21, U22, U23, U24: EL357N; OptoIsolation-EL357N-G

Connections:
5V_PWR: D37.2, D42.2, R74.1, R85.1, RELAY3.1, RELAY4.1, U12.4, U13.4, U20.4, U21.4, U22.4, U23.4, U24.4
24V/12V: C22.2, C23.2, C24.2, C25.2, C30.2, D25.1 (K), D32.1 (K), D33.1 (K), D35.1 (K), D39.1 (K), J12.2, J20.2, J21.2, J23.2, J25.2, R62.1, R63.1, R66.1, R71.1, R80.1
FAN_IN2: C22.1, D20.2 (K), D25.2 (A), J12.1, Q9.3 (D)
GND: R34.2, R38.2, R40.2, R68.2, R69.2, R77.2, R78.2
GND_PWR: Q9.2 (S), Q11.2 (S), Q12.2 (S), Q13.2 (S), Q14.2 (S), Q16.2 (S), Q17.2 (S), R64.2, R65.2, R67.2, R72.2, R75.2, R81.2, R86.2
LIGHT_IN2: C30.1, D38.2 (K), D39.2 (A), J25.1, Q16.3 (D)
unnamed: D20.1 (A), R62.2
unnamed: D23.1 (A), R63.2
unnamed: D24.1 (A), R66.2
unnamed: D34.1 (A), R71.2
unnamed: D36.1 (A), R74.2
unnamed: D36.2 (K), D37.1, Q14.3 (D), RELAY3.4
unnamed: D38.1 (A), R80.2
unnamed: D40.1 (A), R85.2
unnamed: D40.2 (K), D42.1, Q17.3 (D), RELAY4.4
unnamed: Q9.1 (G), R49.2, R64.1
unnamed: Q11.1 (G), R50.2, R65.1
unnamed: Q12.1 (G), R51.2, R67.1
unnamed: Q13.1 (G), R70.2, R72.1
unnamed: Q14.1 (G), R73.2, R75.1
unnamed: Q16.1 (G), R79.2, R81.1
unnamed: Q17.1 (G), R82.2, R86.1
unnamed: R34.1, U12.2
unnamed: R38.1, U13.2
unnamed: R40.1, U20.2
unnamed: R49.1, U12.3
unnamed: R50.1, U13.3
unnamed: R51.1, U20.3
unnamed: R68.1, U21.2
unnamed: R69.1, U22.2
unnamed: R70.1, U21.3
unnamed: R73.1, U22.3
unnamed: R77.1, U23.2
unnamed: R78.1, U24.2
unnamed: R79.1, U23.3
unnamed: R82.1, U24.3
PUMP_IN2: C25.1, D34.2 (K), D35.2 (A), J23.1, Q13.3 (D)
RELAY1_IN1: J24.2, RELAY3.2
RELAY1_IN2: J24.1, RELAY3.3
RELAY2_IN1: J26.2, RELAY4.2
RELAY2_IN2: J26.1, RELAY4.3
STM_FAN: U12.1
STM_NET: U23.1
STM_PUMP: U21.1
STM_RELAY1: U22.1
STM_RELAY2: U24.1
STM_VAN1: U20.1
STM_VAN2: U13.1
VAN1_IN2: C24.1, D24.2 (K), D33.2 (A), J21.1, Q12.3 (D)
VAN2_IN2: C23.1, D23.2 (K), D32.2 (A), J20.1, Q11.3 (D)

Notes on the sheet:
TRƯỜNG ĐẠI HỌC CÔNG NGHỆ KỸ THUẬT TP.HCM
HUỲNH VÕ PHÚC LỘC 22146344
SVTH: BÙI HOÀNG PHÚC 22146372
CONTROL NODE - POWER STAGE
NGUYỄN VĂN NGỌC 22146358
GVHD: TS.NGUYỄN VĂN THÁI
